rvangelder11/Big-Digital-clock-with-5-inch-displays/PCB/PCB_schematic.png

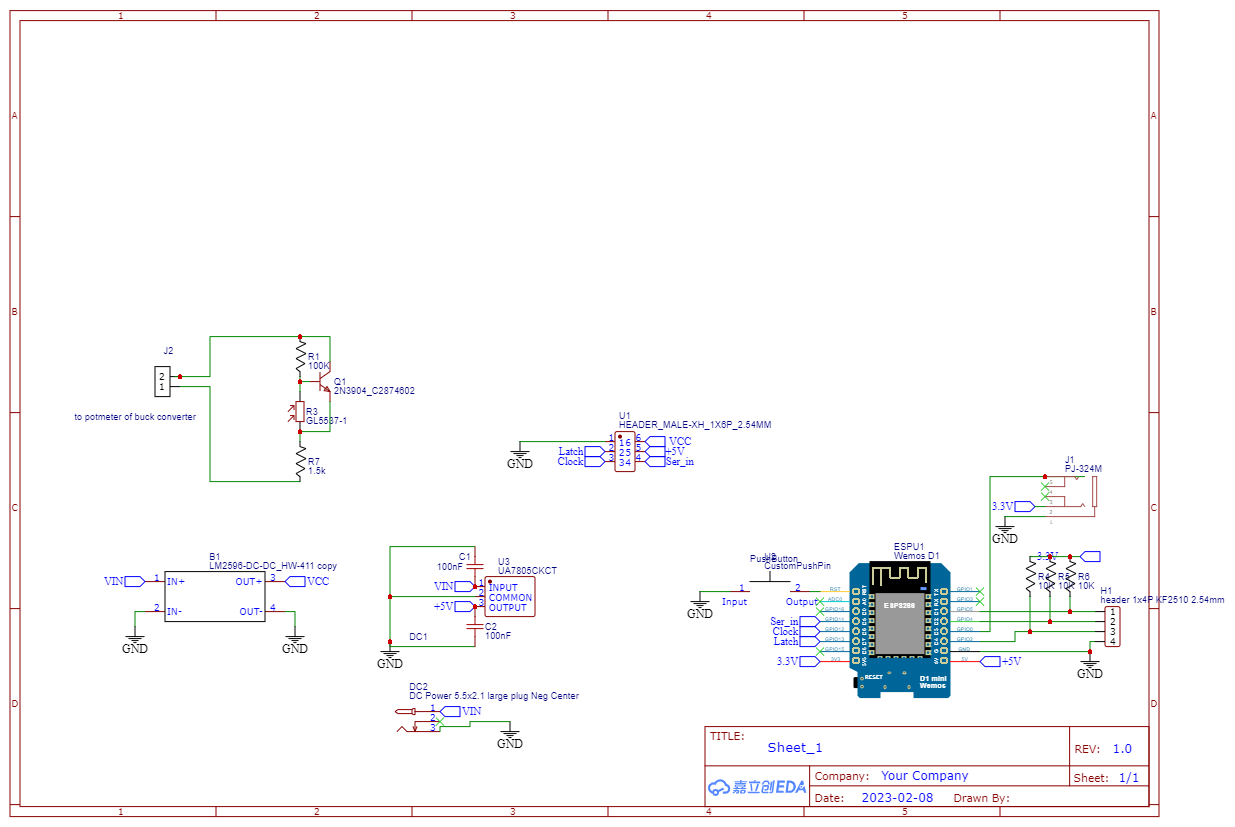
PCB/PCB_schematic.png
