rvangelder11/Big-Digital-clock-with-5-inch-displays/Tech Docs/40101.jpg

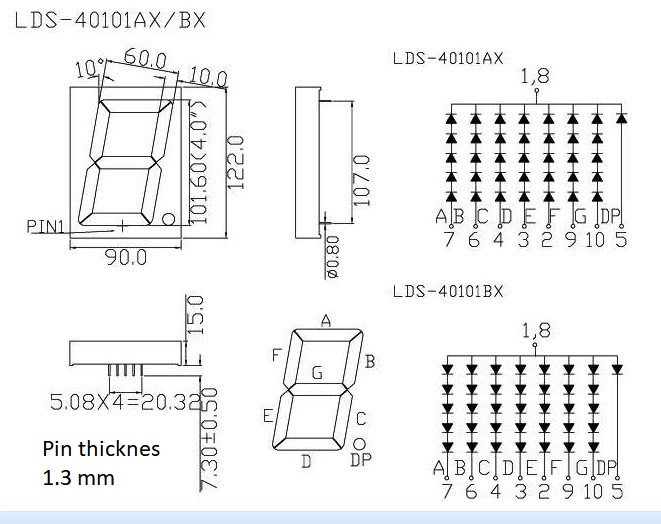
Tech Docs/40101.jpg
