rvangelder11/Big-Digital-clock-with-5-inch-displays/Tech Docs/Parts List 6 x 5 inch displays.md

- 1x black passepartout 50x70cm (local bookstore)
- 1x black Ribba picture frame 50x70 cm (IKEA)
- 1x ESP8266 Wemos D1 (AliExpress)
- 6x 5 inch 7 segment displays 50101BS (AliExpress)
- 6x DC 5V TPIC6C596 Large Digit Driver Driver (AliExpress)
- 1x power supply 3-15v, 3A, EU or US depending on need (AliExpress)
- 6x 6 wire Dupont cable 10 cm Female-Female (AliExpress)
- 2x LM2596 buck converter  or 1x LM2596 and 1x 7805 5V regulator (AliExpress)
- Mounting material to mount backside of picture frame
