rvangelder11/Big-Digital-clock-with-5-inch-displays/(commit log)

2023-07-31 Create Assembly instructions.md
2023-07-31 Update Assembly instructions.md
2023-08-01 changed PCB
2023-08-01 Delete Gerber_PCB_grote 7 segment displays_2_2023-07-16.zip
    outdated
2023-08-01 Added PCB drawings
2023-08-01 Create Explanation of PCB.md
2023-08-01 Update Explanation of PCB.md
